linker3000/Microbit-TVPong/fuses-MiniPro v6.60.png

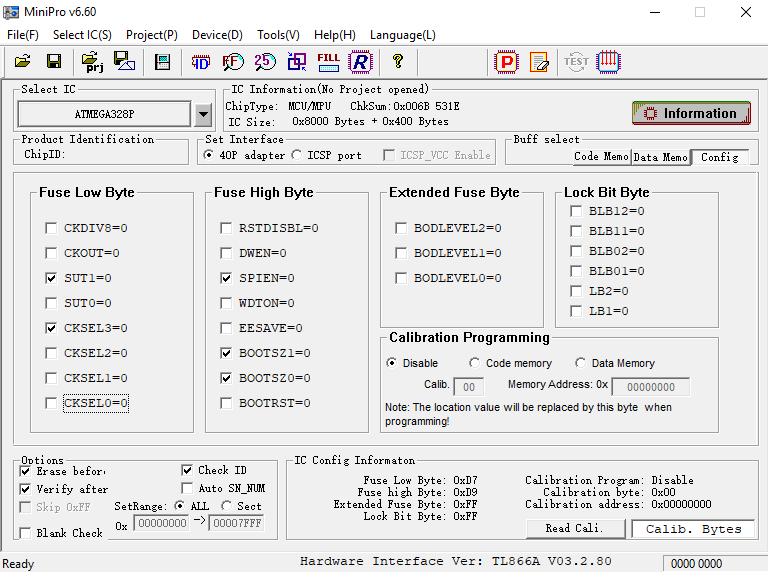
fuses-MiniPro v6.60.png
