linker3000/Microbit-TVPong/(commit log)

2018-03-03 Added schematic
2018-03-04 Revised pin annotations
2018-03-15 Updated schematic (minor)
